manoelledeviron/CoolTeam/Documenten/Ontwerp_schema.png

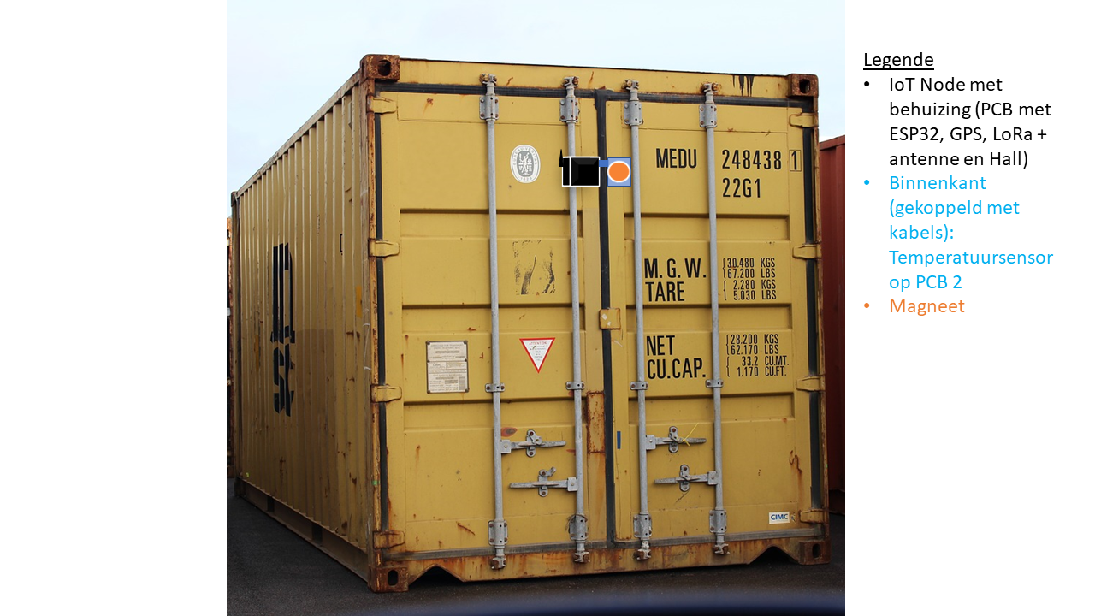
Documenten/Ontwerp_schema.png
