manoelledeviron/CoolTeam/Schema/READ ME.txt

Please place the bitmap on the silkscreen bottom.
