manoelledeviron/CoolTeam/Documenten/IoTNodeSchema.pptx

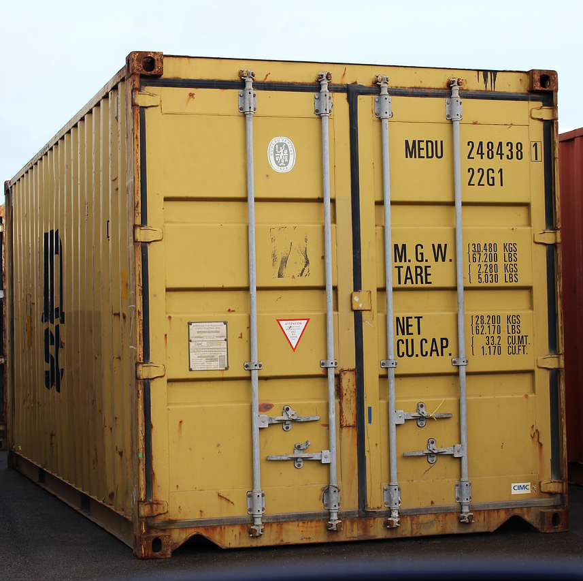
[picture p2: figure]

Legende
- IoT Node met behuizing (PCB met ESP32, GPS, LoRa + antenne en Hall)
- Binnenkant (gekoppeld met kabels): Temperatuursensor op PCB 2
- Magneet
