manoelledeviron/CoolTeam/Documenten/CoolTeam_Structure.pptx

PCB2 (binnen container)

Temp-sensor

Antenne

PCB1 (buiten container)

GPS

LoRaWAN

Antenne

3.3V

Hall-sensor (deur)

I2C

ESP32

UART

Analoog

I2C

3.3V

3.3V

Voeding (batterij)

Buck/Boost/...

3.3V
