manoelledeviron/CoolTeam/Documenten/CoolTeam_Structure.png

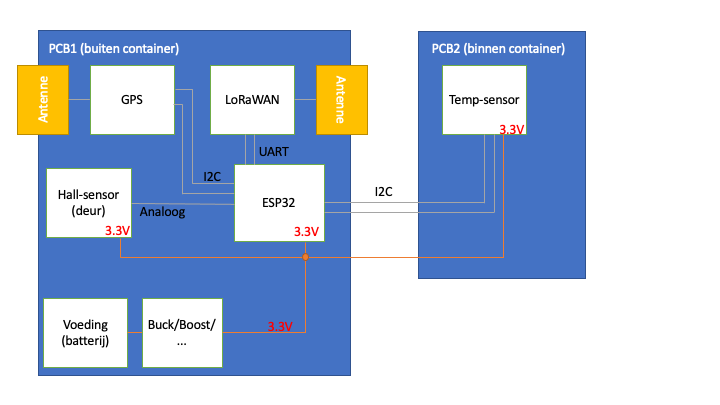
Documenten/CoolTeam_Structure.png
