manoelledeviron/CoolTeam/Schema/SchemaPCB1.png

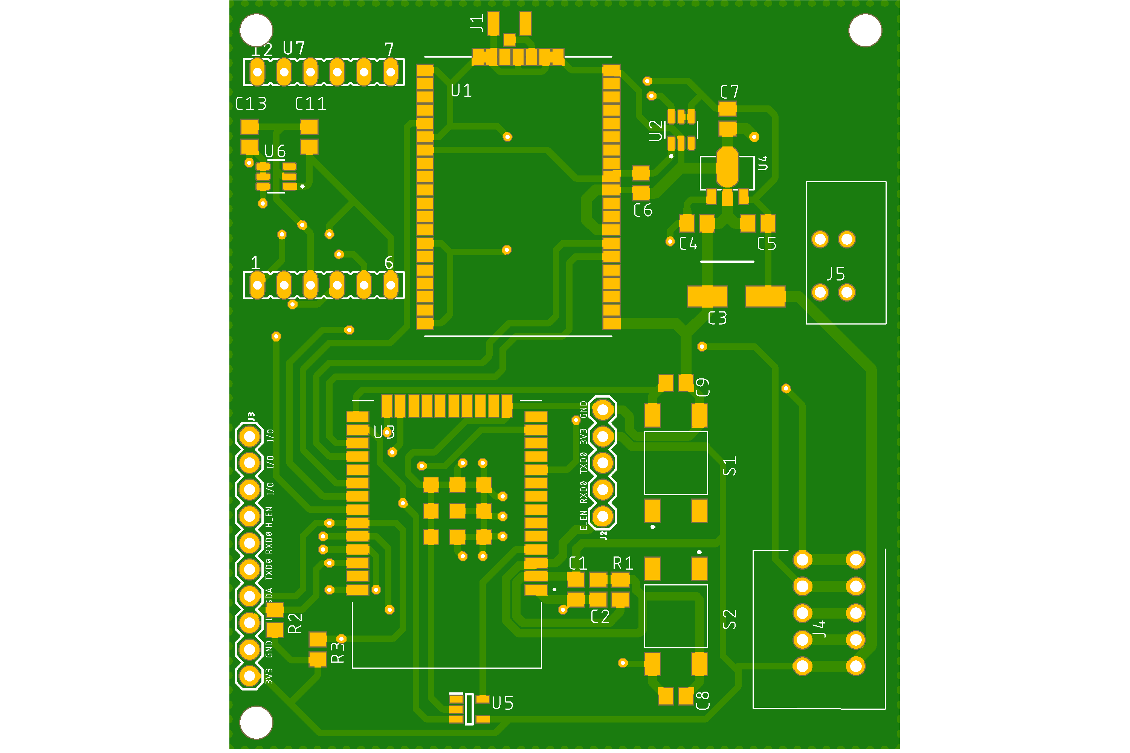
Schema/SchemaPCB1.png
