manoelledeviron/CoolTeam/Schema/SensorBordje/pcb2.png

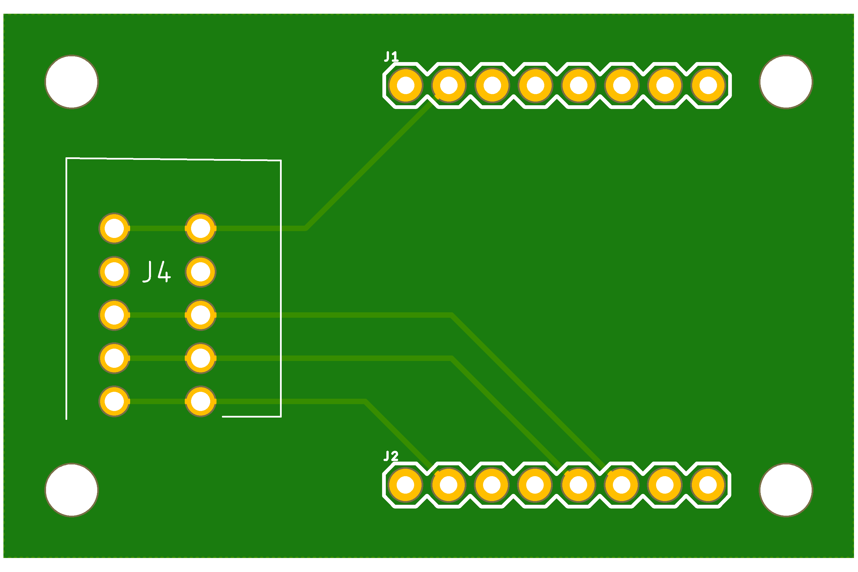
Schema/SensorBordje/pcb2.png
