manoelledeviron/CoolTeam/Documenten/BOM PCB.xlsx

Naam | Component | Aantal v. 1 board | Aantal v.alle boards | reserve | Totaal aantal nodig | Leverancier | Link | Footprint | Eenheidsprijs | Totaalprijs
U3 | ESP32-WROOM-32E 16MB | 1 | 2 | 0 | 2 | mouser | link (https://www.mouser.be/ProductDetail/Espressif-Systems/ESP32-WROOM-32EM113EH2800PH3Q0) |  | 2.64 € | 5.28 €
J2 | ufl connector | 1 | 2 | 0 | 2 | mouser | link (https://www.mouser.be/ProductDetail/Hirose-Connector/UFL-R-SMT-110?qs=kL1ClTr6oBoOdtqlGQpQrQ==) |  | 1.07 € | 2.14 €
U1 | RN2483 module | 1 | 2 | 0 | 2 | mouser | link (https://www.mouser.be/ProductDetail/Microchip-Technology/RN2483A-I-RM105) |  | 11.38 € | 22.76 €
U2,U6, | TPS22860DBVR | 3 | 6 | 2 | 8 | mouser | link (https://www.mouser.be/ProductDetail/Texas-Instruments/TPS22860DBVR) | sot-23 | 0.82 € | 6.58 €
C1,C2,C6,C8,C9,C11 | Condensator 100nF 0805 | 6 | 12 | 3 | 15 | mouser | link (https://www.mouser.be/ProductDetail/KEMET/C0805C104K9RACAUTO?qs=ds50AKTGxA84SWre%252BvImOA%3D%3D) | C0805 | 0.18 € | 2.73 €
C4,C5,C7,C13 | Condensator 1µF 0805 | 4 | 8 | 2 | 10 | mouser | link (https://www.mouser.be/ProductDetail/KEMET/C0805X105K8RAC7210?qs=ds50AKTGxA8Ac4j4qbsB5A%3D%3D) | C0805 | 0.62 € | 6.18 €
C3 | elco 22uF 20% | 1 | 2 | 1 | 3 | mouser | link (https://www.mouser.be/ProductDetail/Lelon/VE-220M1VTR-0605) |  | 0.18 € | 0.55 €
R1,R2,R3 | weerstand 10k | 3 | 6 | 4 | 10 | mouser | link (https://www.mouser.be/ProductDetail/Bourns/CMP0805AFX-1002ELF?qs=TiOZkKH1s2RdWJm6UffAxg%3D%3D) | R0805 | 0.05 € | 0.52 €
U4 | LDO 2-10V In, 3,3v out, 35uA sleep | 1 | 2 | 1 | 3 | mouser | link (https://www.mouser.be/ProductDetail/Torex-Semiconductor/XC6231A332PR-G?qs=AsjdqWjXhJ%252BxcfXSnf052A%3D%3D) | SOT-89-5 | 0.71 € | 2.13 €
S1,S2 | pushbutton SPST NO | 2 | 4 | 1 | 5 | mouser | link (https://www.mouser.be/ProductDetail/E-Switch/LL3301NF065QG) |  | 0.44 € | 2.20 €
 | 5 pin molex connector | 2 | 4 | 0 | 4 | mouser | link (https://www.mouser.be/ProductDetail/Molex/39700-0205) |  | 2.24 € | 8.96 €
 | 2 pin molex connector | 1 | 2 | 0 | 2 | mouser | link (https://www.mouser.be/ProductDetail/Molex/39700-0002?qs=EibfsPFbZaqB1%252BjDW0HuPQ==) |  | 0.88 € | 1.76 €
 | female pinheader 8 | 2 | 4 | 0 | 4 | mouser | link (https://www.mouser.be/ProductDetail/Gravitech/8Fx1L-254mm?qs=fkzBJ5HM%252BdAyuablm941Ag%3D%3D) |  | 0.50 € | 2.01 €
U7 | Adafruit Mini GPS | 1 | 2 | -1 | 1 | mouser | link (https://www.mouser.be/ProductDetail/Adafruit/4415?qs=xZ%2FP%252Ba9zWqatKwX%252B9rp%2FIw%3D%3D) |  | 25.37 € | 25.37 €
 | female pinheader 6 | 2 | 4 | 0 | 4 | mouser | link (https://www.mouser.be/ProductDetail/Gravitech/6fx1L-254mm) |  | 0.60 € | 2.42 €
(niet op schema) | ufl to sma cable | 1 | 2 | 0 | 2 | mouser | link (https://www.mouser.be/ProductDetail/Linx-Technologies/CSI-SGFB-200-UFFR?qs=j%252B1pi9TdxUbSdkGQ9Cz4wA%3D%3D) |  | 4.73 € | 9.46 €
(niet op schema) | sma antenna | 1 | 2 | 0 | 2 | mouser | link (https://www.mouser.be/ProductDetail/Linx-Technologies/ANT-868-CW-RCL-SMA?qs=yqaQSyyJnNjYZYtNBmiiMQ%3D%3D) |  | 7.35 € | 14.70 €
 |  |  |  |  |  |  |  |  | Totaalprijs componenten: | 115.75 €
 | Aantal verwacht te maken boards
 | 2
