manoelledeviron/CoolTeam/Documenten/BOM-list prototype.xlsx

Distributor | product | quantity | Prijs | weblink to product | Opmerking
RS-Components | Microchip LoRa Mote RN2483 LoRa Development Board DM164138 | 1 |  | weblink (https://benl.rs-online.com/web/p/communication-wireless-development-tools/9125363/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)
RS-Components | HDC2080 breakout board (temp + RH sens) | 1 |  | weblink (https://benl.rs-online.com/web/p/sensor-development-tools/1884831/?searchHistory=%7B%22enabled%22%3Atrue%7D) | AL IN LABO?? (project vorig semester)
mouser | ESP32-DevKitC-32E | 1 |  | weblink (https://www.mouser.be/ProductDetail/Espressif-Systems/ESP32-DevKitC-32E/?qs=GedFDFLaBXFpgD0kAZWDrQ%3D%3D)
Mouser | Si7217-B-01-IVR, Hall Effect Sensors, 5-Pin SOT-23 | 1 |  | weblink (https://www.mouser.be/ProductDetail/Silicon-Labs/SI7217-B-01-IV/?qs=gt1LBUVyoHnprJJrsP0PQw%3D%3D)
mouser | breakout SOT-23 | 1 |  | weblink (https://www.mouser.be/ProductDetail/Adafruit/1230?qs=GURawfaeGuCUOuKQqtofyQ==)
mouser | Adafruit Mini GPS PA1010D | 1 | 25.37 € | weblink (https://www.mouser.be/ProductDetail/Adafruit/4415/?qs=xZ%2FP%252Ba9zWqatKwX%252B9rp%2FIw%3D%3D)
