manoelledeviron/CoolTeam/Datasheets/ESP32-WROOM-32E/esp32-devkitc-v4_reference_design/05_BOM List/ESP32-DevKitC-V4-(ESP32-SOLO-1)-BOMList(V1.2)-20180621A.xlsx

ESP32-DevKitC-V4 BOMList(V1.2)
ID | Qty | Ref Des | Value | Package | ICs | Description
1 | 3 | C1, C3, C21 | 22 uF/10V (20%) | 0603 | Capacitor | Ceramic Capacitor
2 | 4 | C9, C14, C19, C22 | 0.1 uF/50V (10%) | 0402 | Capacitor | Ceramic Capacitor
3 | 1 | C20 | 4.7 uF/6.3V (10%) | 0402 | Capacitor | Ceramic Capacitor
4 | 1 | D1 | RED LED | 0603 | Diode | light-emitting diode: Red
5 | 1 | D2 | ESP-WROOM-32 | ESP32_MODULE | Module | ESP32-SOLO-1 (3.3V 32 Mbit)
6 | 1 | D3 | BAT760-7 | SOD323 | Diode | Schottky Diode, Vrrm=30V, Vr=21V, I=1A, IFSM=5.5A
7 | 3 | D4, D5, D6 | LESD5D5.0CT1G | SOD-523 | Diode | ESD, TVS Diode, 5V
8 | 1 | J1 | Micro USB Type B Female 5 Pin DIP/插件 | USB_5P | Connector | Micro USB
9 | 2 | Q1, Q2 | S8050 | SOT-23-3 | Transistor | Transistor
10 | 2 | R2, R24 | 2K (5%) | 0402 | Resistor | Chip Resistors
11 | 3 | R11, R21, R22 | 10K (5%) | 0402 | Resistor | Chip Resistors
12 | 2 | R17, R18 | 0R (5%) | 0402 | Resistor | Chip Resistors
13 | 1 | R25 | 22.1K (5%) | 0402 | Resistor | Chip Resistors
14 | 1 | R26 | 47.5K (5%) | 0402 | Resistor | Chip Resistors
15 | 2 | SW1, SW2 | SW push button | Tact Switch | Tact Switch | 复位按键，2 脚，3x4x2，贴片 (reset button, 2-pin, 3x4x2, SMT)
16 | 2 | J2, J3 | CON19X1_2P54 | CON19_2P54 | Connector | Male PCB Single Row Straight Header Connector, 2.54 mm Pitch, 19 Pins
17 | 1 | U1 | CP2102N-A01-GQFN28 | CP2102_QFN_28P | Interface ICs | USB-to-UART, USB2.0 full speed, data rate up to 3M baud
18 | 1 | U2 | AMS1117-3.3 | SOT-223 | Power ICs | LDO, 5V 转 3.3V 固定输出, 1A, SOT-223 (LDO, 5V/3.3V, 1A, SOT-223)
