manoelledeviron/CoolTeam/Documenten/CoolTeam_Planning.xlsx

Sheet: Planning
Column1 | Maandag | Dinsdag | Woensdag | Donderdag | Vrijdag | Zaterdag | Zondag | TO DO
Week 1 | 2021-02-15 | 2021-02-16 | 2021-02-17 | 2021-02-18 | 2021-02-19 | 2021-02-20 | 2021-02-21 | planning
Deadline |  |  |  | Eerste versie BOM |  |  |  | rolverdeling (technisch en niet-technisch)
Doing | Labo: intro + uitwerken opdracht+ eerste versie BOM + eerste planning |  |  |  |  |  |  | schema circuit (blokschema)
Week 2 | 2021-02-22 | 2021-02-23 | 2021-02-24 | 2021-02-25 | 2021-02-26 | 2021-02-27 | 2021-02-28
Deadline
Doing
Week 3 | 2021-03-01 | 2021-03-02 | 2021-03-03 | 2021-03-04 | 2021-03-05 | 2021-03-06 | 2021-03-07
Deadline
Doing | verder uitwerken planning + verder uitwerken opdracht
Week 4 | 2021-03-08 | 2021-03-09 | 2021-03-10 | 2021-03-11 | 2021-03-12 | 2021-03-13 | 2021-03-14
Deadline
Doing
Week 5 | 2021-03-15 | 2021-03-16 | 2021-03-17 | 2021-03-18 | 2021-03-19 | 2021-03-20 | 2021-03-21
Deadline | PCBs + BOM PCB's
Doing |  | testen van GPS
Week 6 | 2021-03-22 | 2021-03-23 | 2021-03-24 | 2021-03-25 | 2021-03-26 | 2021-03-27 | 2021-03-28
Deadline
Doing |  |  |  | werken aan labo: testen van LoRa, Hall en temp sensor
Week 7 | 2021-03-29 | 2021-03-30 | 2021-03-31 | 2021-04-01 | 2021-04-02 | 2021-04-03 | 2021-04-04
Deadline |  |  |  | PCB + BOM PCB
Doing
Week 8 | 2021-04-05 | 2021-04-06 | 2021-04-07 | 2021-04-08 | 2021-04-09 | 2021-04-10 | 2021-04-11
Deadline
Doing
Week 9 | 2021-04-12 | 2021-04-13 | 2021-04-14 | 2021-04-15 | 2021-04-16 | 2021-04-17 | 2021-04-18
Deadline
Doing
Week 10 | 2021-04-19 | 2021-04-20 | 2021-04-21 | 2021-04-22 | 2021-04-23 | 2021-04-24 | 2021-04-25
Deadline
Doing | Solderen + testen PCBs, programmeren?
Week 11 | 2021-04-26 | 2021-04-27 | 2021-04-28 | 2021-04-29 | 2021-04-30 | 2021-05-01 | 2021-05-02
Deadline
Doing | Solderen + testen PCBs, programmeren + Initiële testen finaal product?
Week 12 | 2021-05-03 | 2021-05-04 | 2021-05-05 | 2021-05-06 | 2021-05-07 | 2021-05-08 | 2021-05-09
Deadline
Doing
Week 13 | 2021-05-10 | 2021-05-11 | 2021-05-12 | 2021-05-13 | 2021-05-14 | 2021-05-15 | 2021-05-16
Deadline | Presentatie + documentatie?
Doing | Finale: field-testen + presentatie

Sheet: Rolverdeling
Soort | Verantwoordelijkheden2 | Niel | Basile | Manoëlle
Technisch
 | PCB
 | schematics | x | x | x
 | pcb |  |  | x
 | Hardware
 | GPS + antenne |  |  | x
 | Hall sensor |  | x
 | LoRaWAN + antenne | x
 | Temperatuur sensor |  | x
 | Energievoorziening |  | x
 | Software
 | GPS |  |  | x
 | Hall sensor |  | x
 | LoRaWAN | x
 | Temperatuur sensor |  | x
 | Energie verbruik | x
 | Behuizing |  | x
 | Dashboard |  |  | x
Niet-technisch
 | Rapportering
 | Documentatie (verslag) |  | x
 | Presentatie | x
 | Planning |  |  | X
 | Budget | x

Sheet: BOM
Distributor | Product | Quantity
RS-Components | Microchip LoRa Mote RN2483 LoRa Development Board DM164138 | 1
RS-Components | HDC2080 breakout board (temp + RH sensor) | 1
Mouser | ESP32-DevKitC-32E | 1
Mouser | Si7217-B-01-IVR, Hall Effect Sensors, 5-pin SOT-23 | 1
Mouser | Breakout SOT-23 | 1
Mouser | Adafruit Mini GPS PA1010D | 1
