manoelledeviron/CoolTeam/3d design/PCB1_Top.stl

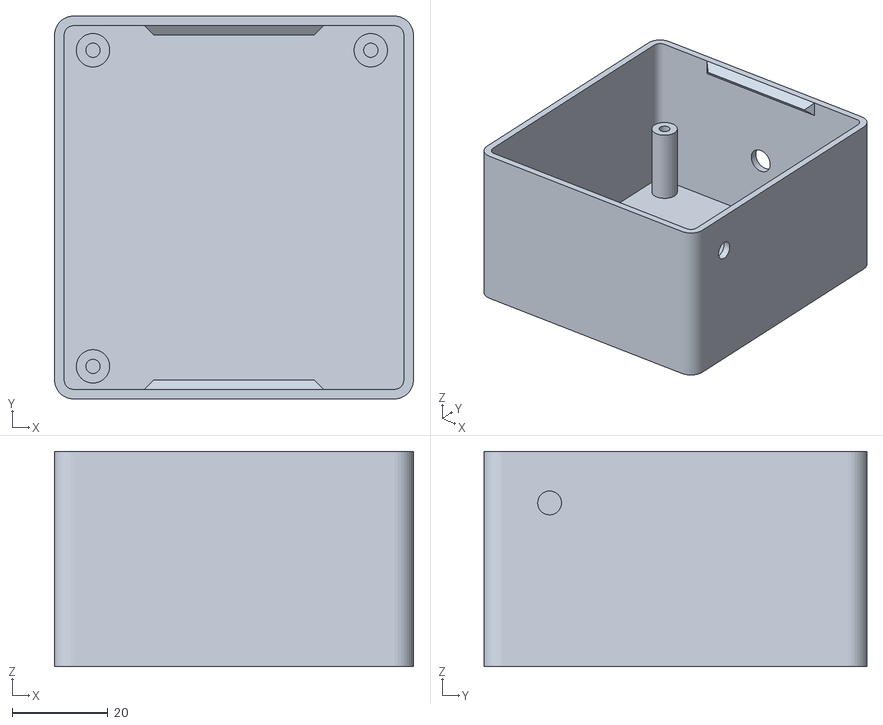
[picture p20: CAD file, 2021-05-10]
3d design/PCB1_Top.stl
75.0 x 80.0 x 45.0
