manoelledeviron/CoolTeam/3d design/PCB1_Base.stl

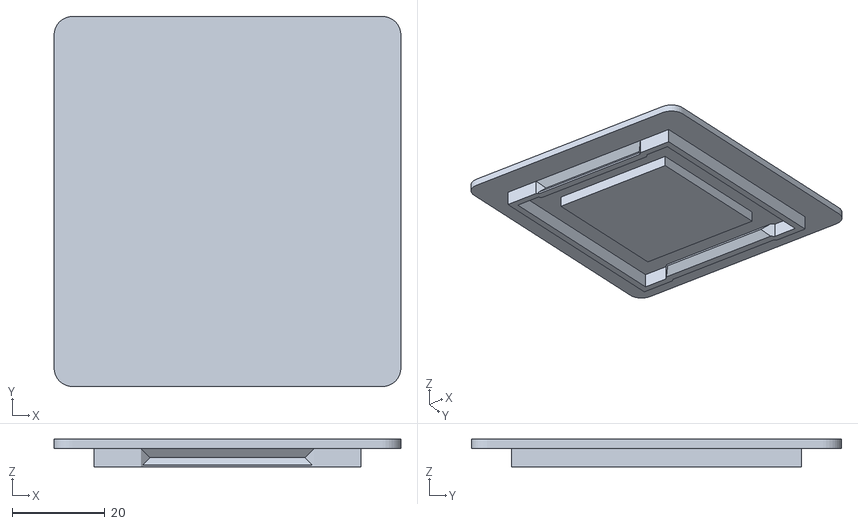
[picture p21: CAD file, 2021-05-10]
3d design/PCB1_Base.stl
75.0 x 80.0 x 6.00
