manoelledeviron/CoolTeam/Schema/PDF/SchemaPCB1.pdf

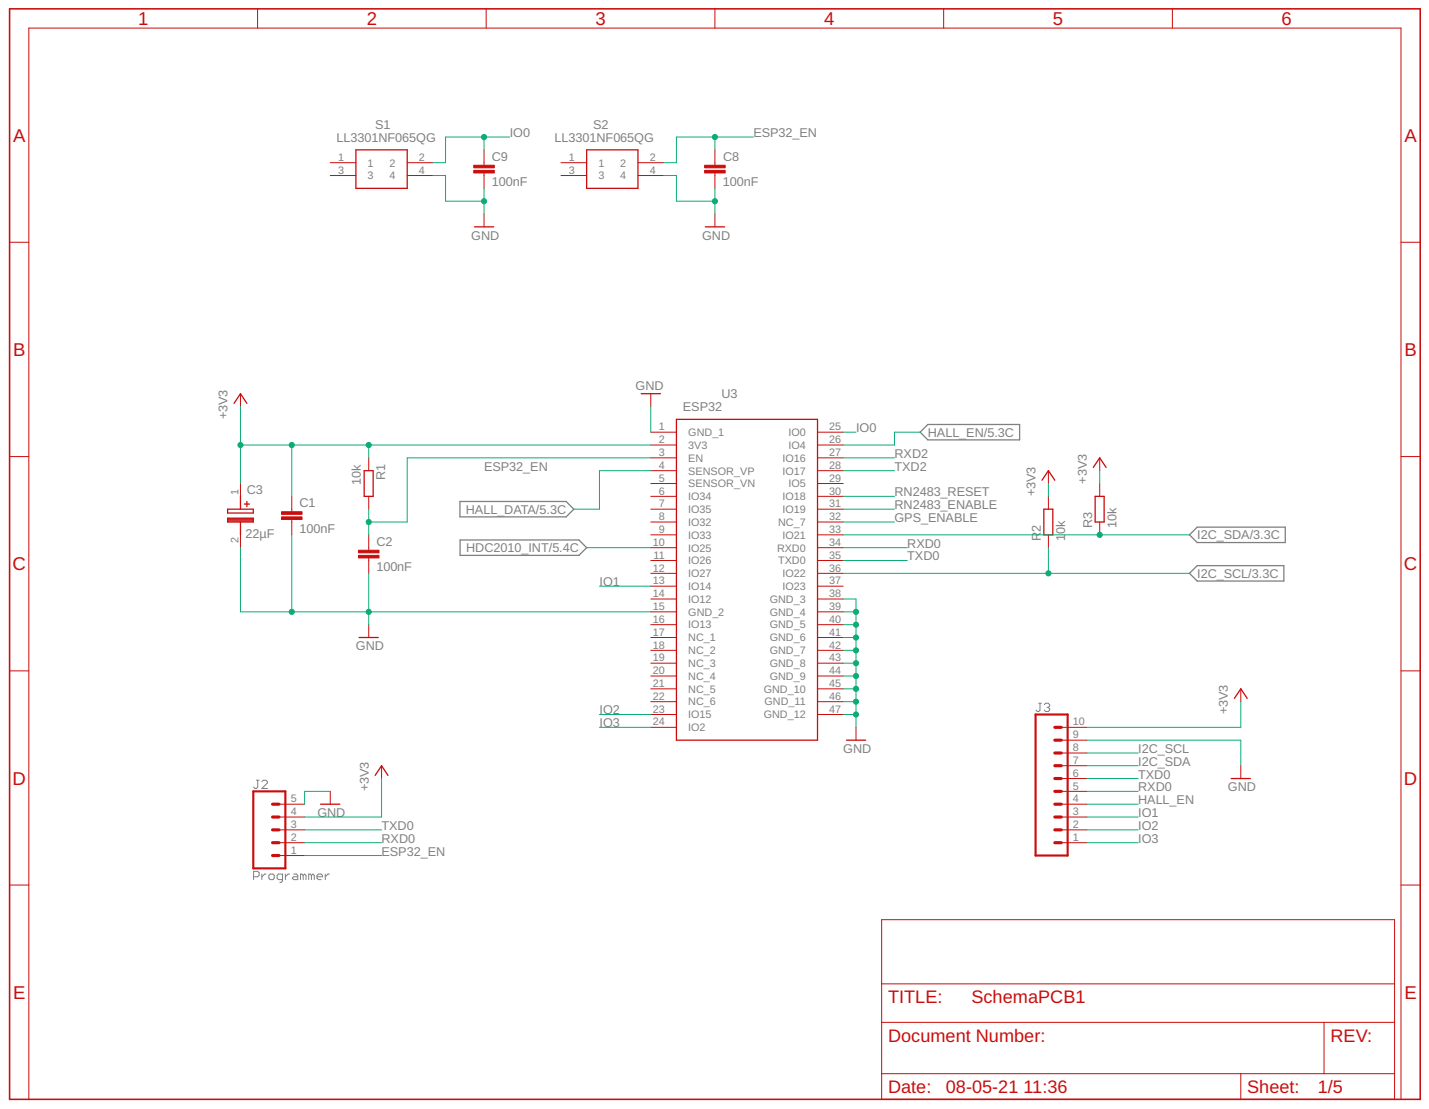
[picture p22: page 1]

IO0 | ESP32_EN

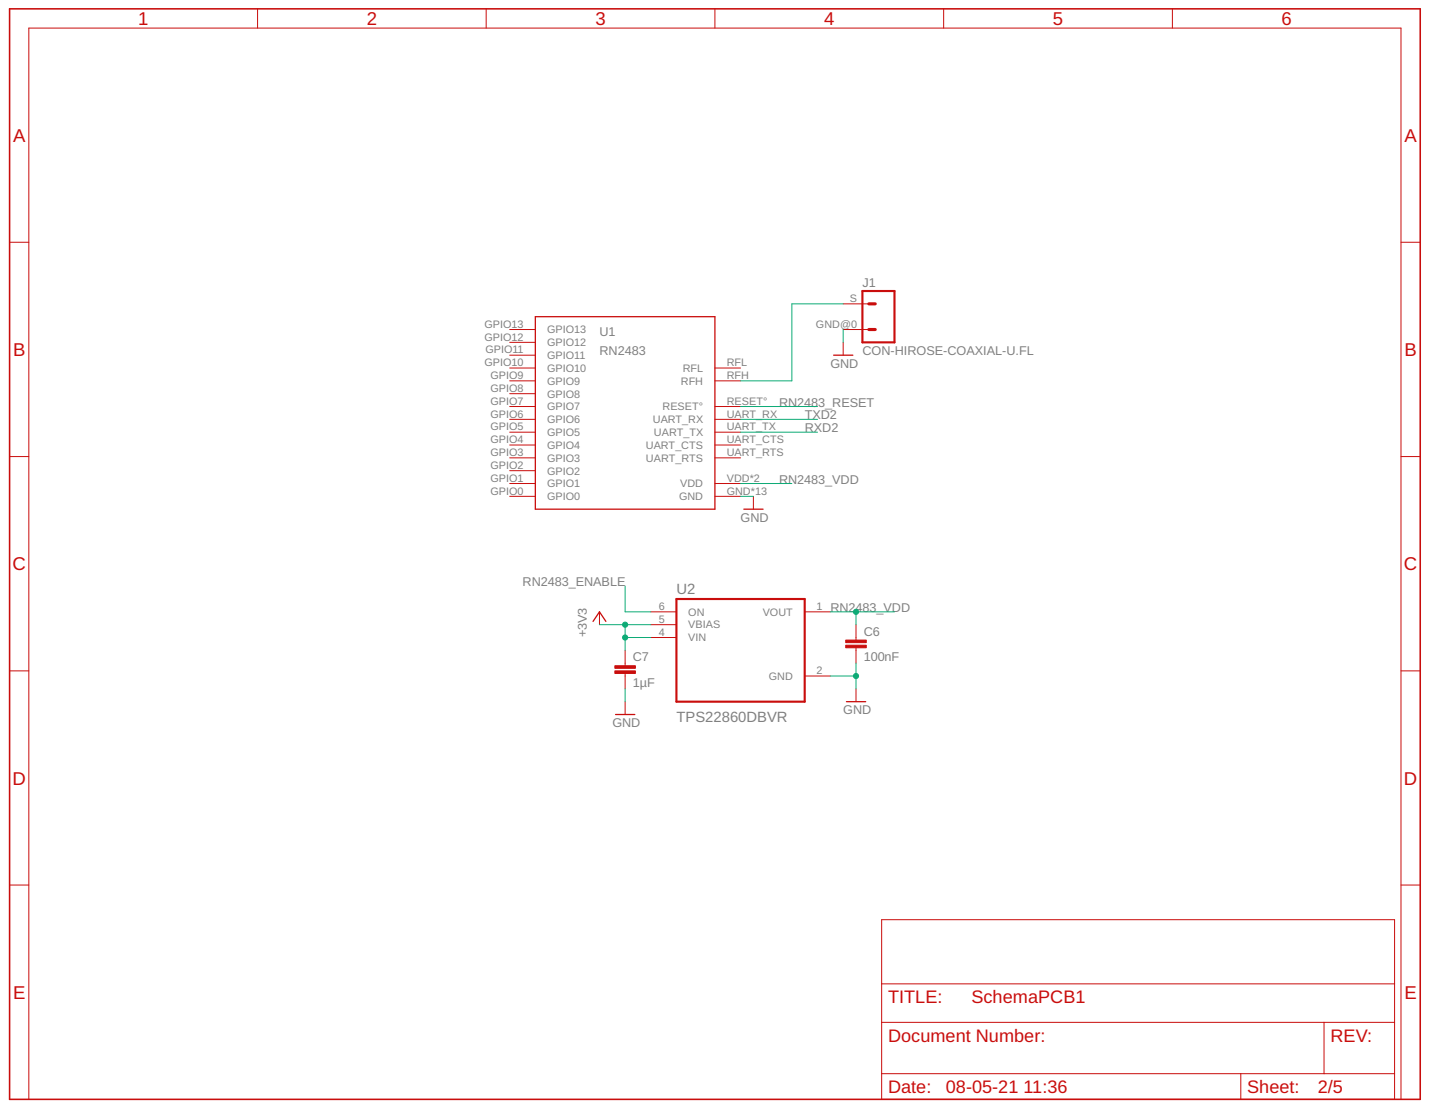
[picture p23: page 2]

CON-HIROSE-COAXIAL-U.FL
GND

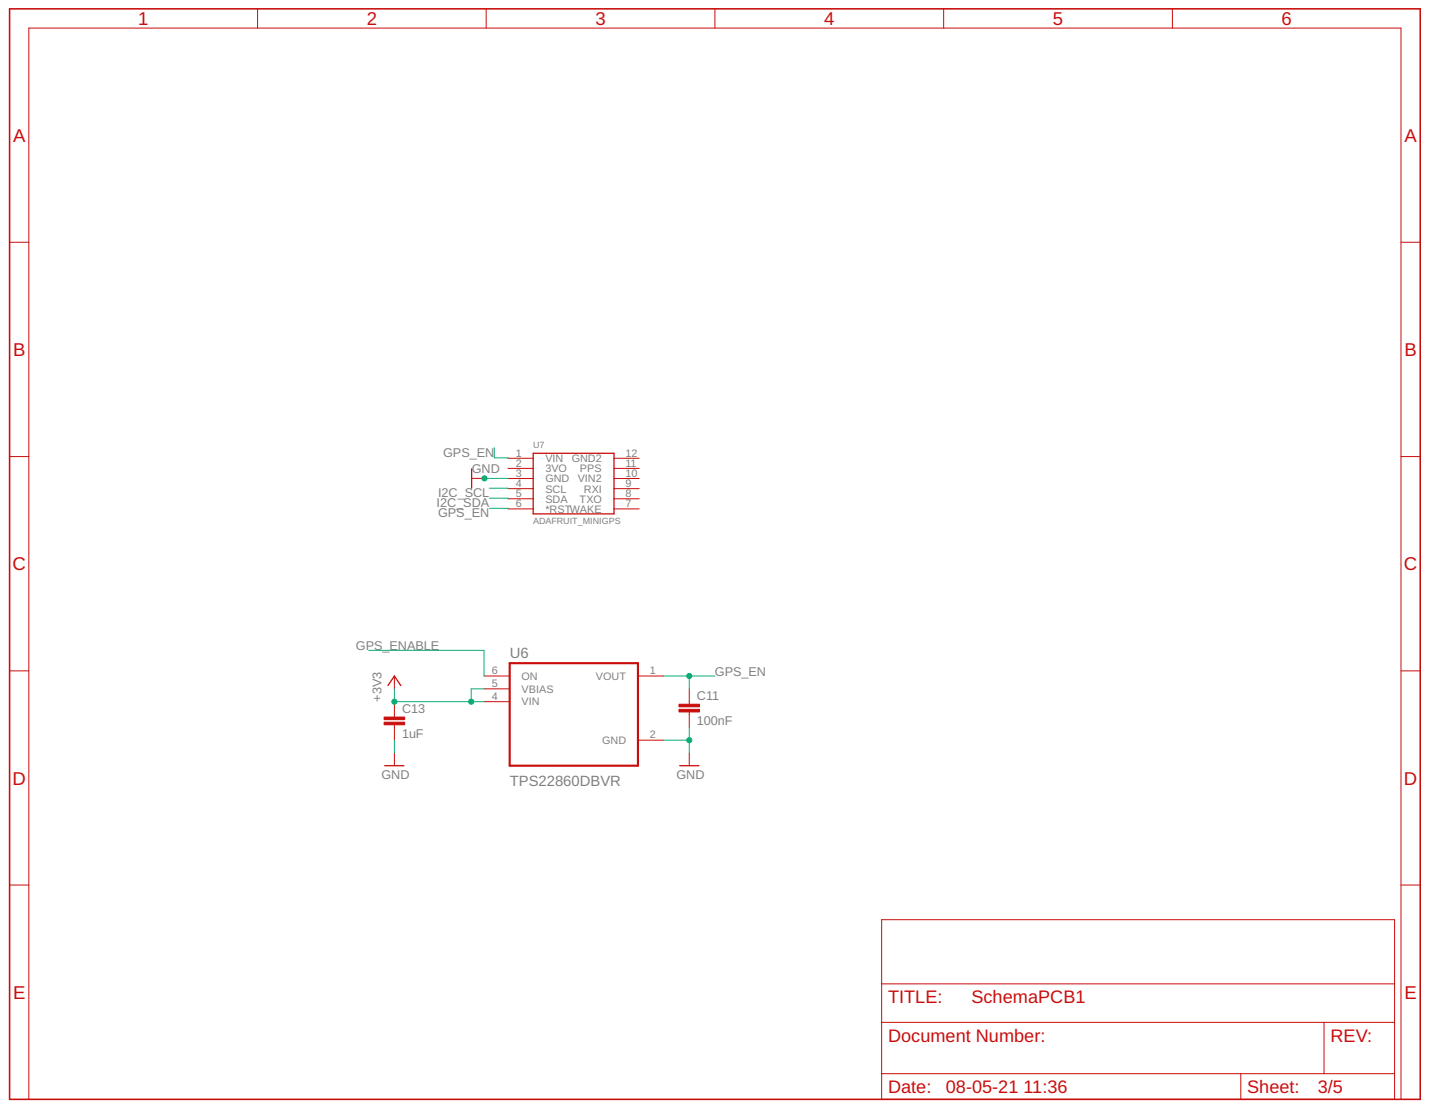
[picture p24: page 3]

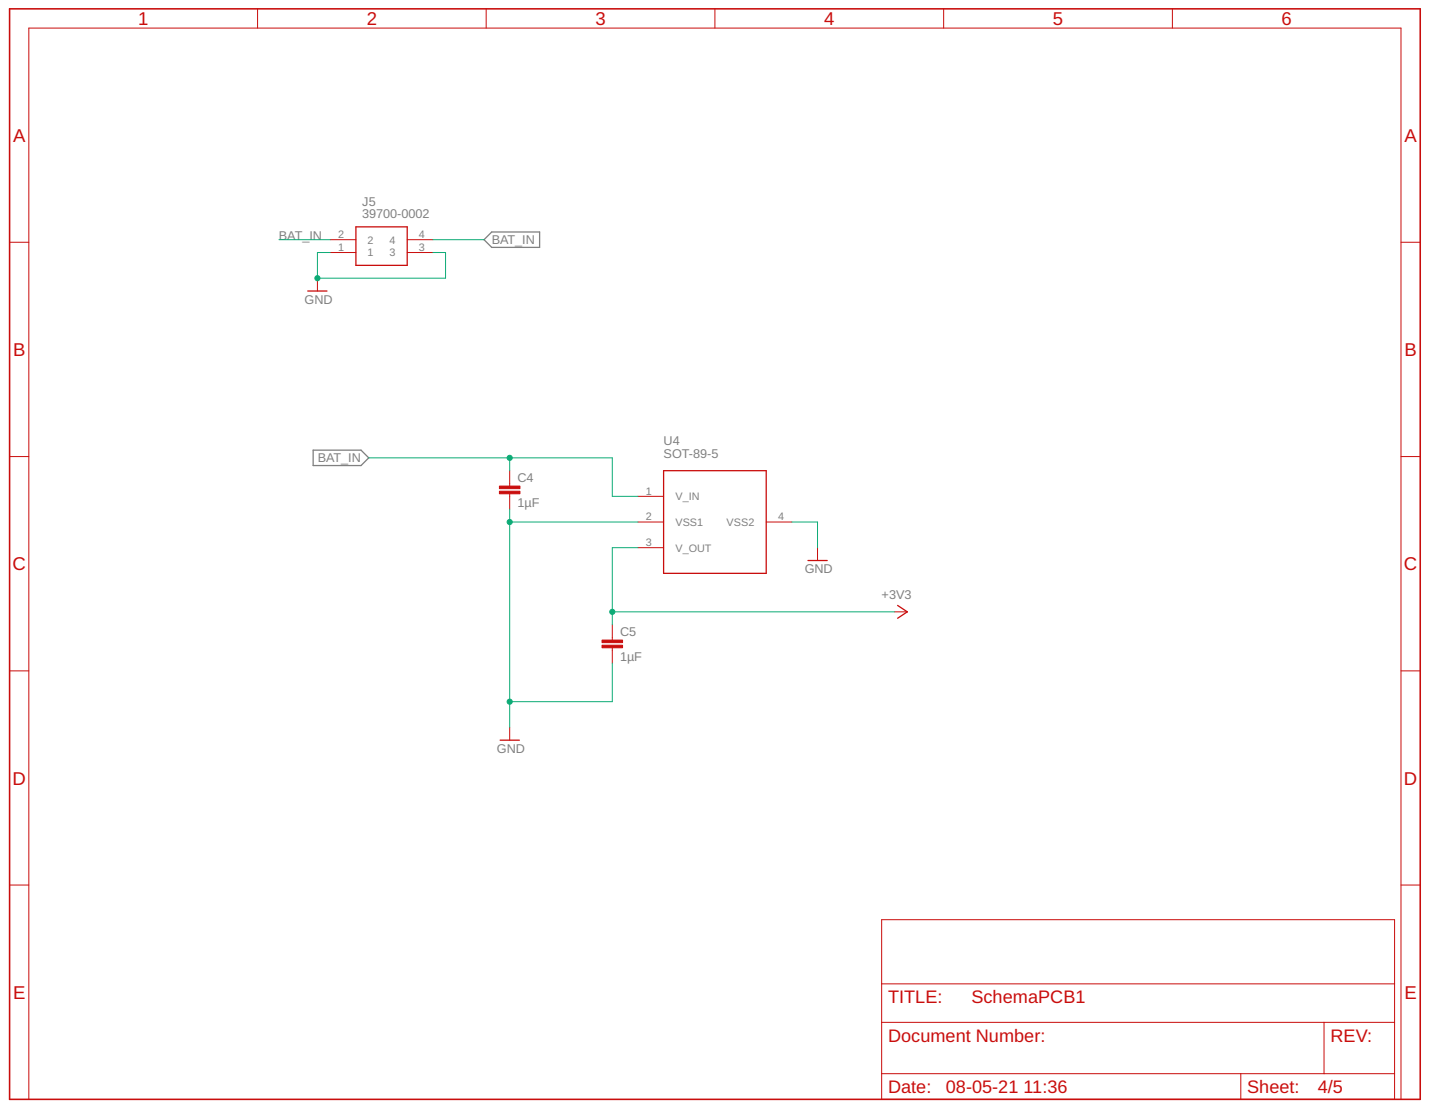
[picture p25: page 4]

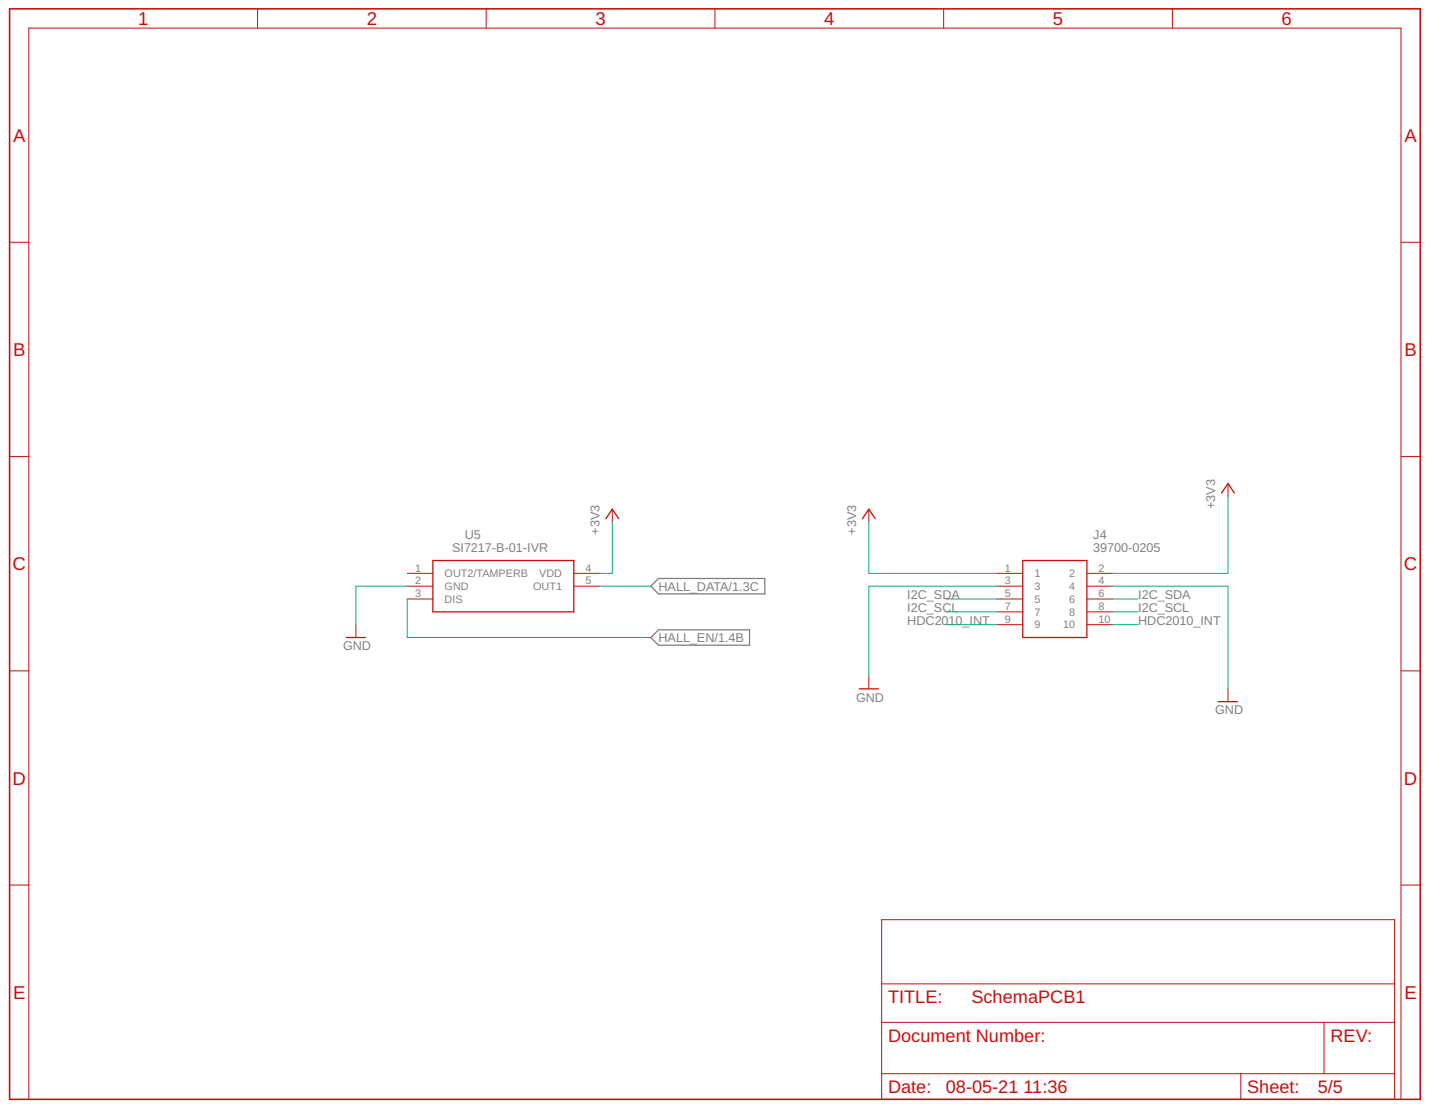
[picture p26: page 5]
