manoelledeviron/CoolTeam/Schema/PDF/pcb2.pdf

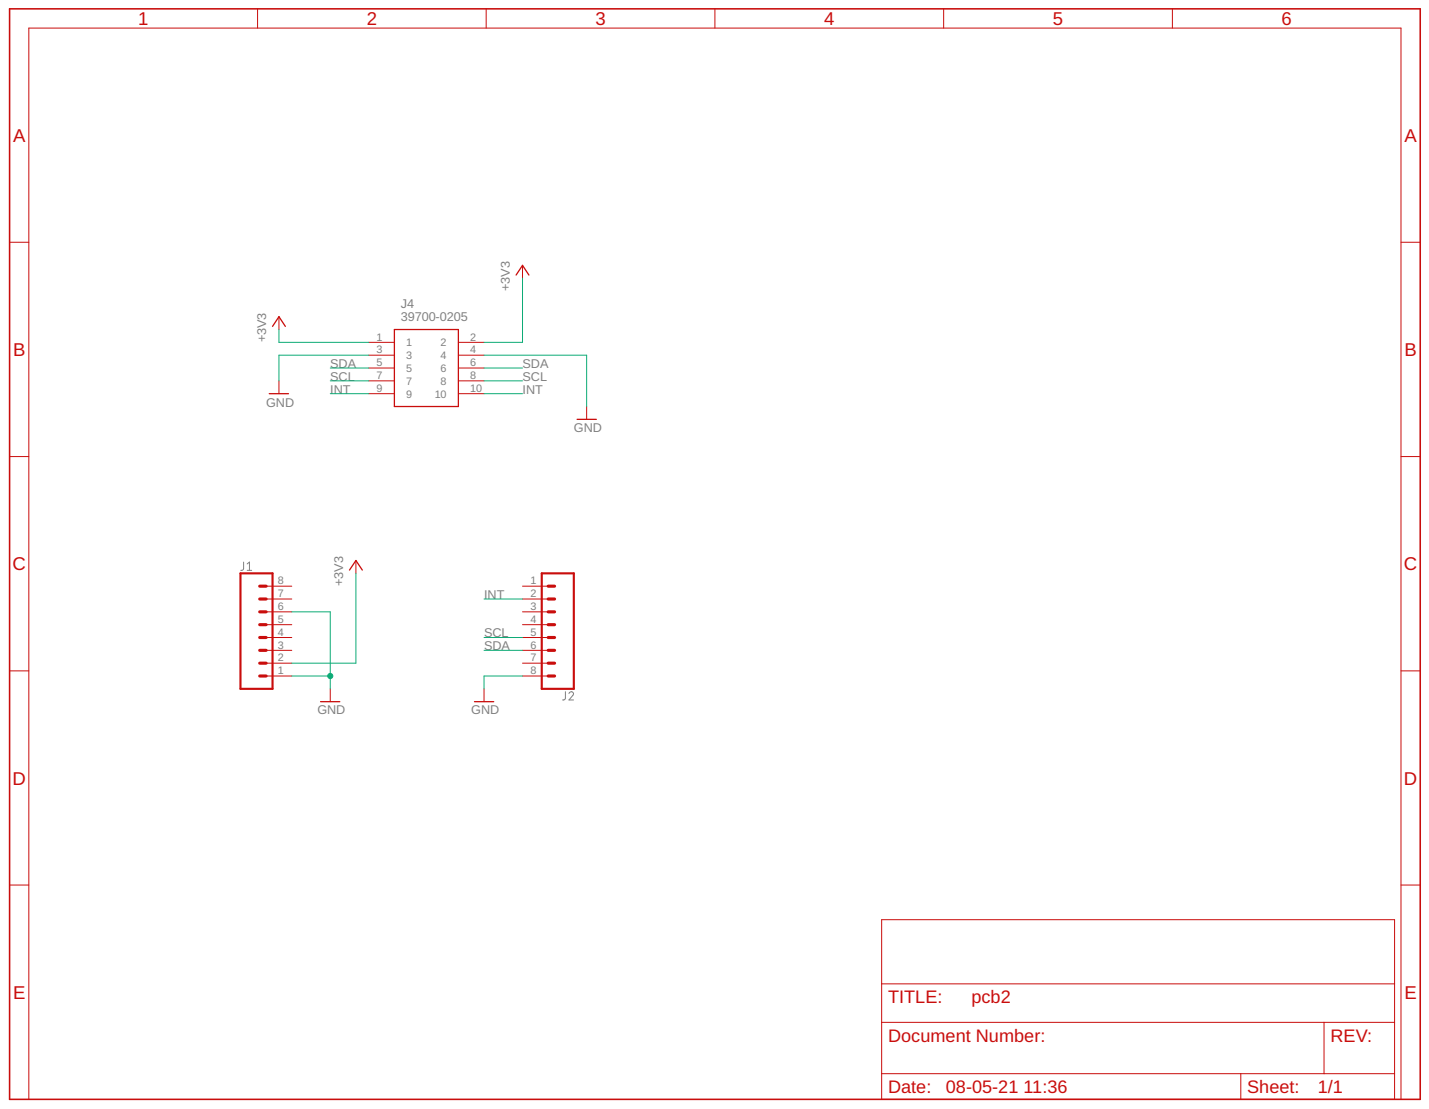
[picture p27: page 1]
