manoelledeviron/CoolTeam/(list of files, drawings)

Other design files:
Datasheets/ESP32-WROOM-32E/esp32-devkitc-v4_reference_design/02_PCB Layout/ESP32-DevKitC-V4_20171206A.pcb
