manoelledeviron/CoolTeam/Schema/SchemaPCB1.brd

## EAGLE design Schema/SchemaPCB1.brd (2021-04-07)

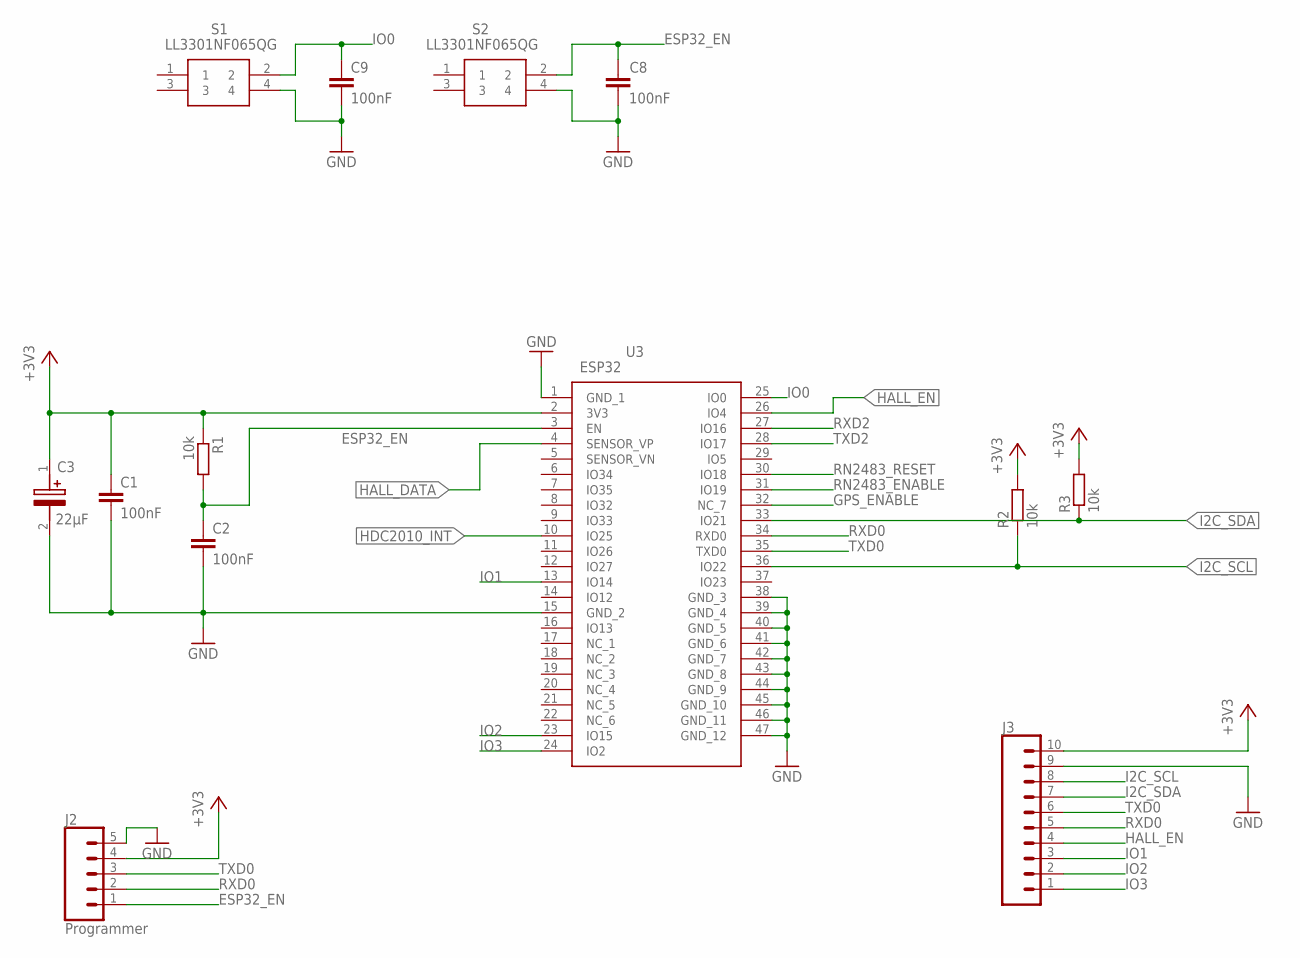
[picture p28: schematic SchemaPCB1.sch, sheet 1, ESP32]

Parts:
C1, C2, C8, C9: 100nF; C0805
C3: 22µF; CAPAE660X550N
J2: Programmer; 1X05
J3: CONN_10"; 1X10
R1: 10k; M0805
R2, R3: 10k; R0805
S1, S2: LL3301NF065QG
U3: ESP32; ESP32WROOM32EM113EH3200PH3Q0

Connections:
+3V3: C1.1, C3.1 (+), J2.4, J3.10, R1.1, R2.2, R3.2, U3.2 (3V3); also elsewhere on the board
ESP32_EN: C2.1, C8.2, J2.1, R1.2, S2.2, U3.3 (EN)
GND: C1.2, C2.2, C3.2 (-), C8.1, C9.2, J2.5, J3.9, S1.4, S2.4, U3.1 (GND_1), U3.15 (GND_2), U3.38 (GND_3), U3.39 (GND_4), U3.40 (GND_5), U3.41 (GND_6), U3.42 (GND_7), U3.43 (GND_8), U3.44 (GND_9), U3.45 (GND_10), U3.46 (GND_11), U3.47 (GND_12); also elsewhere on the board
GPS_ENABLE: U3.32 (NC_7); also elsewhere on the board
HALL_DATA: U3.4 (SENSOR_VP); also elsewhere on the board
HALL_EN: J3.4, U3.26 (IO4); also elsewhere on the board
HDC2010_INT: U3.10 (IO25); also elsewhere on the board
I2C_SCL: J3.8, R2.1, U3.36 (IO22); also elsewhere on the board
I2C_SDA: J3.7, R3.1, U3.33 (IO21); also elsewhere on the board
IO0: C9.1, S1.2, U3.25 (IO0)
IO1: J3.3, U3.13 (IO14)
IO2: J3.2, U3.23 (IO15)
IO3: J3.1, U3.24 (IO2)
RN2483_ENABLE: U3.31 (IO19); also elsewhere on the board
RN2483_RESET: U3.30 (IO18); also elsewhere on the board
RXD0: J2.2, J3.5, U3.34 (RXD0)
RXD2: U3.27 (IO16); also elsewhere on the board
TXD0: J2.3, J3.6, U3.35 (TXD0)
TXD2: U3.28 (IO17); also elsewhere on the board

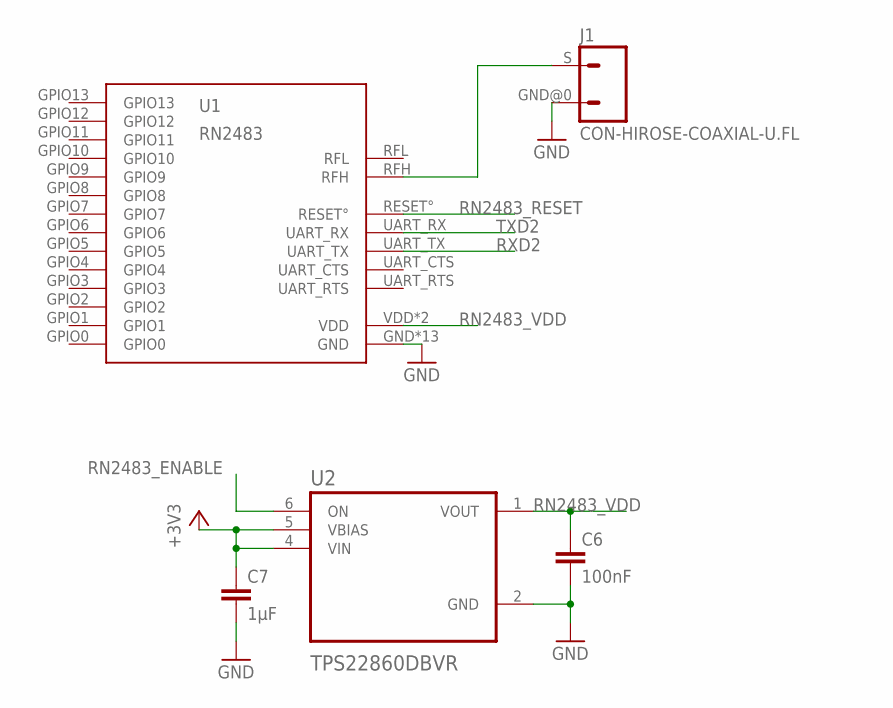
[picture p29: schematic SchemaPCB1.sch, sheet 2, LoRa]

Parts:
C6: 100nF; C0805
C7: 1µF; C0805
J1: CON-HIROSE-COAXIAL-U.FL; CON-U.FL
U1: RN2483
U2: TPS22860DBVR; SOT95P280X145-6N

Connections:
+3V3: C7.1, U2.4 (VIN), U2.5 (VBIAS); also elsewhere on the board
GND: C6.2, C7.2, J1.GND@0 (2), U1.GND, U1.GND1 (GND), U1.GND2 (GND), U1.GND3 (GND), U1.GND4 (GND), U1.GND5 (GND), U1.GND6 (GND), U1.GND7 (GND), U1.GND8 (GND), U1.GND9 (GND), U1.GND10 (GND), U1.GND11 (GND), U1.GND12 (GND), U2.2 (GND); also elsewhere on the board
unnamed: J1.S (1), U1.RFH
RN2483_ENABLE: U2.6 (ON); also elsewhere on the board
RN2483_RESET: U1.RESET°; also elsewhere on the board
RN2483_VDD: C6.1, U1.VDD, U1.VDD2 (VDD), U2.1 (VOUT)
RXD2: U1.UART_TX; also elsewhere on the board
TXD2: U1.UART_RX; also elsewhere on the board

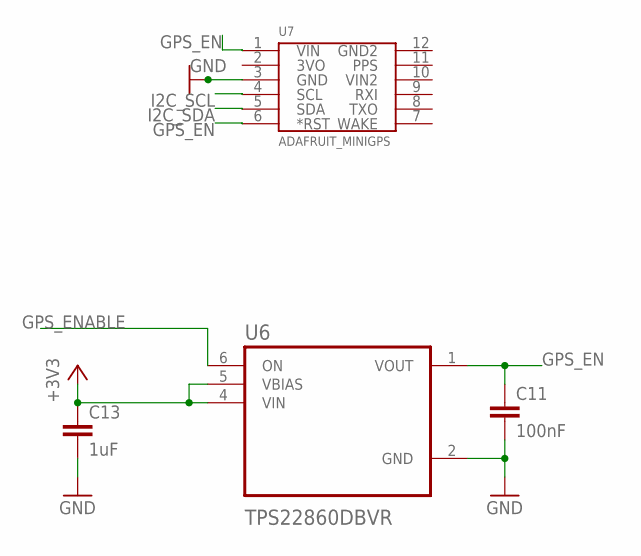
[picture p30: schematic SchemaPCB1.sch, sheet 3, GPS]

Parts:
C11: 100nF; C0805
C13: 1uF; C0805
U6: TPS22860DBVR; SOT95P280X145-6N
U7: ADAFRUIT_MINIGPS

Connections:
+3V3: C13.1, U6.4 (VIN), U6.5 (VBIAS); also elsewhere on the board
GND: C11.2, C13.2, U6.2 (GND), U7.3 (GND); also elsewhere on the board
GPS_EN: C11.1, U6.1 (VOUT), U7.1 (VIN), U7.6 (*RST)
GPS_ENABLE: U6.6 (ON); also elsewhere on the board
I2C_SCL: U7.4 (SCL); also elsewhere on the board
I2C_SDA: U7.5 (SDA); also elsewhere on the board

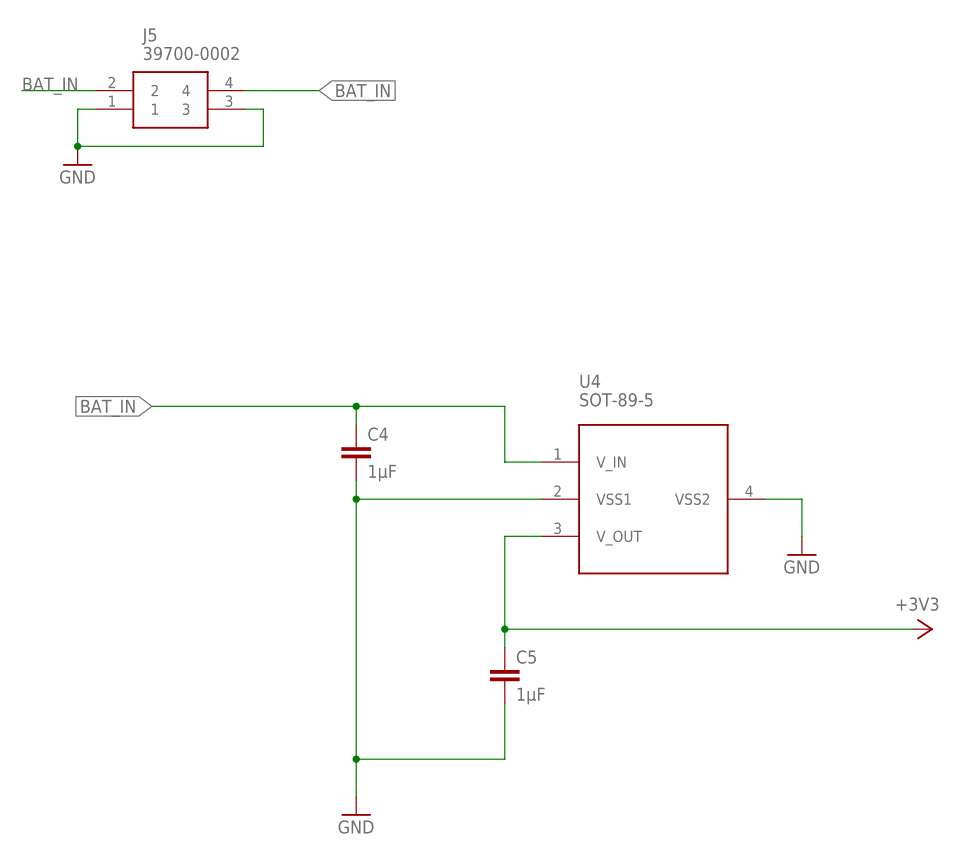
[picture p31: schematic SchemaPCB1.sch, sheet 4, Power]

Parts:
C4, C5: 1µF; C0805
J5: 39700-0002; 397000002
U4: SOT-89-5; SOT-89

Connections:
+3V3: C5.1, U4.3 (V_OUT); also elsewhere on the board
BAT_IN: C4.1, J5.2, J5.4, U4.1 (V_IN)
GND: C4.2, C5.2, J5.1, J5.3, U4.2 (VSS1), U4.4 (VSS2); also elsewhere on the board

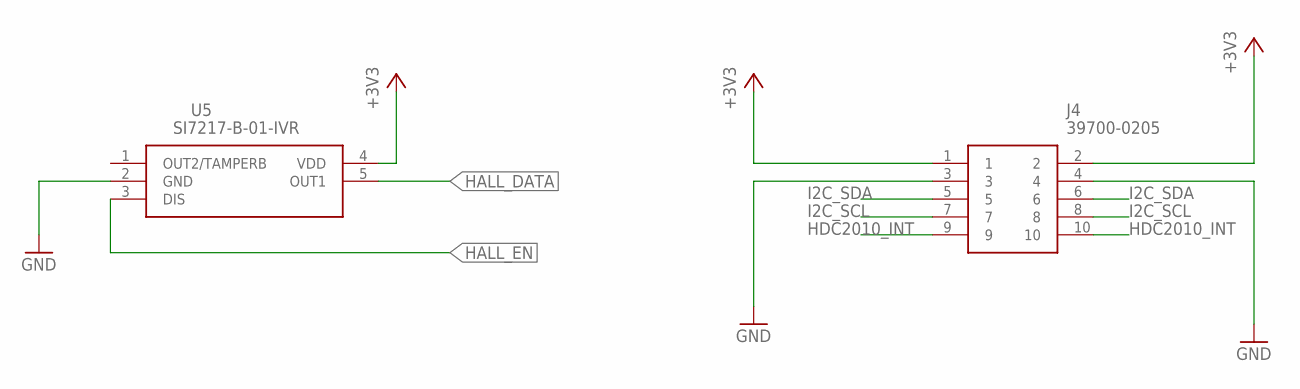
[picture p32: schematic SchemaPCB1.sch, sheet 5, Sensoren]

Parts:
J4: 39700-0205; 397000205
U5: SI7217-B-01-IVR; SOT95P275X125-5N

Connections:
+3V3: J4.1, J4.2, U5.4 (VDD); also elsewhere on the board
GND: J4.3, J4.4, U5.2 (GND); also elsewhere on the board
HALL_DATA: U5.5 (OUT1); also elsewhere on the board
HALL_EN: U5.3 (DIS); also elsewhere on the board
HDC2010_INT: J4.9, J4.10; also elsewhere on the board
I2C_SCL: J4.7, J4.8; also elsewhere on the board
I2C_SDA: J4.5, J4.6; also elsewhere on the board

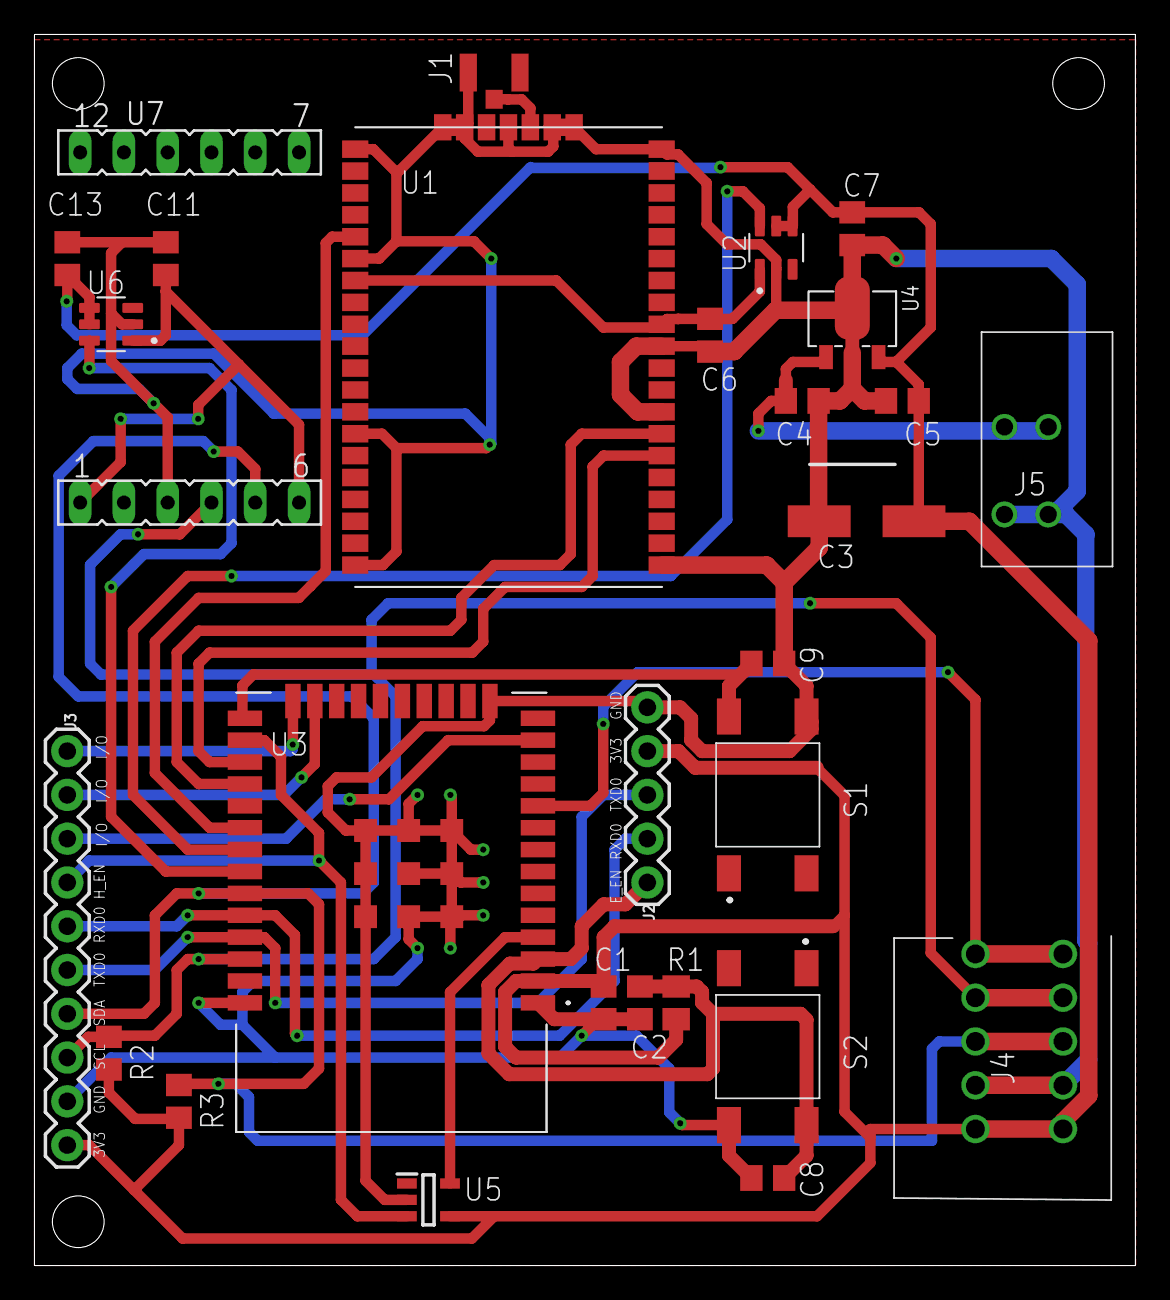
[picture p33: board SchemaPCB1.brd from above]

Board: 2 copper layers, 63.9 x 71.4 mm, 28 parts (0 on the bottom side), 23 nets.
