manoelledeviron/CoolTeam/Schema/SensorBordje/pcb2.brd

## EAGLE design Schema/SensorBordje/pcb2.brd (2021-04-03)

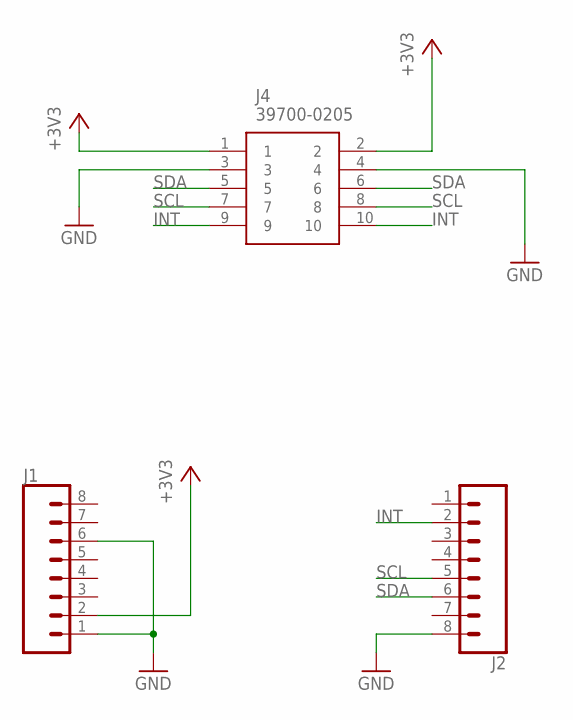
[picture p34: schematic pcb2.sch]

Parts:
J1, J2: CONN_08"; 1X08
J4: 39700-0205; 397000205

Connections:
+3V3: J1.2, J4.1, J4.2
GND: J1.1, J1.6, J2.8, J4.3, J4.4
INT: J2.2, J4.9, J4.10
SCL: J2.5, J4.7, J4.8
SDA: J2.6, J4.5, J4.6

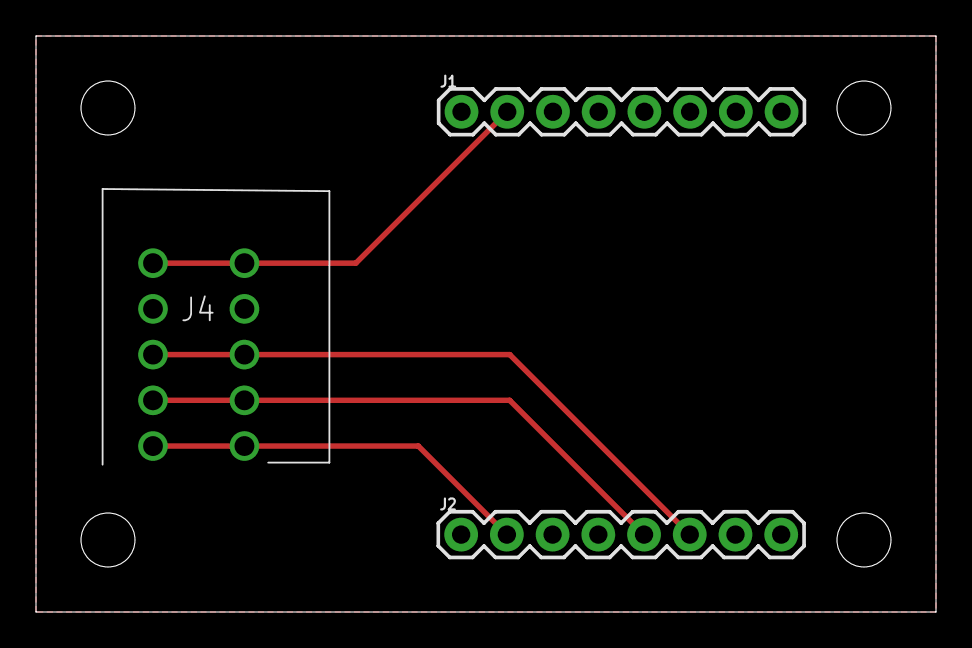
[picture p35: board pcb2.brd from above]

Board: 2 copper layers, 50.0 x 32.0 mm, 3 parts (0 on the bottom side), 5 nets.
