manoelledeviron/CoolTeam/(commit log)

2021-03-15 planning en structuur toegevoegd
    [CoolTeam_Planning.xlsx]
2021-03-16 planning en takenverdeling aangepast
    [CoolTeam_Planning.xlsx]
2021-03-17 hall datasheet added
    [BOM-list versie 1.xlsx]
2021-03-18 Schema + lib
    [BOM-list prototype.xlsx, SchemaPCB1.sch]
2021-03-18 schema + pcb bom
    [BOM PCB.xlsx, ESP32-DevKitC-V4-(ESP32-SOLO-1)-BOMList(V1.2)-20180621A.xlsx, ESP32-DevKitC-V4-(ESP32-WROOM-32)-BOMList(V1.1)-20180607A.xlsx, ESP32-DevKitC-V4-(ESP32-WROOM-32D)-BOMList(V1.1)-20180607A.xlsx, ESP32-DevKitC-V4-(ESP32-WROOM-32U)-BOMList(V1.1)-20180607A.xlsx, ESP32-DevKitC-V4_20171206A.pcb, SchemaPCB1.sch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]
2021-03-26 LoRa toegevoegd
    RN2483 en power voorziening voor de RN2483 aangebracht op het schema
    [SchemaPCB1.sch]
2021-03-26 Update BOM PCB.xlsx
    toevoegen componenten LoRa
    [BOM PCB.xlsx]
2021-03-28 buck bom list added
    [BOM PCB.xlsx, SchemaPCB1.sch]
2021-03-28 buck added (shcema en bom)
    [BOM PCB.xlsx, SchemaPCB1.sch]
2021-03-31 LoRa schema afgewerkt
    Klaar voor board te maken
    [SchemaPCB1.sch]
2021-03-31 schema dingen
    [BOM PCB.xlsx, SchemaPCB1.sch]
2021-04-01 Board begonnen
    [SchemaPCB1.brd, SchemaPCB1.sch]
2021-04-01 gps toegevoegd
    [SchemaPCB1.brd, SchemaPCB1.sch]
2021-04-01 ferrite bead toegevoegd
    [SchemaPCB1.sch]
2021-04-01 pull-up toegevoegd op I2C gps
    [SchemaPCB1.brd, SchemaPCB1.sch]
2021-04-01 gps schema aangepast
    [SchemaPCB1.brd, SchemaPCB1.sch]
2021-04-02 Bezig aan board
    [SchemaPCB1.brd, SchemaPCB1.sch]
2021-04-02 mosfet symbool en footprint aangepast
    [SchemaPCB1.sch]
2021-04-02 Eagle fix
    Board bijna klaar
    [SchemaPCB1.brd, SchemaPCB1.sch]
2021-04-03 laatste componenten en pcb2 toegevoegd
    [BOM PCB.xlsx, SchemaPCB1.brd, SchemaPCB1.sch, pcb2.brd, pcb2.sch]
2021-04-03 BOARD klaar
    [SchemaPCB1.brd]
2021-04-03 gerbers added
    [SchemaPCB1.brd, SchemaPCB1.sch, pcb2.brd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]
2021-04-03 bom update
    [BOM PCB.xlsx]
2021-04-03 BOM aangepast
    [BOM PCB.xlsx]
2021-04-07 aangepast om te gebruiken met gps breakout board
    [SchemaPCB1.brd, SchemaPCB1.sch]
2021-04-07 gerber files geexporteerd
    [SchemaPCB1.brd, SchemaPCB1.sch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]
2021-04-08 export pcb1 aangepast, BOM PCB aangepast
    [BOM PCB.xlsx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]
2021-04-08 oude gerbers gedelete
    [copper_bottom.gbr, copper_top.gbr, drill_1_16.xln, gerber_job.gbrjob, profile.gbr, silkscreen_bottom.gbr, silkscreen_top.gbr, soldermask_bottom.gbr]
2021-04-09 Update BOM PCB.xlsx
    [BOM PCB.xlsx]
2021-05-03 main code Basile aangepast met GPS
    [BOM PCB.xlsx]
2021-05-09 png files toegevoegd van pcbs
